diondokter/Tscrump-Weather-Station/App/WhatsApp Image 2017-02-02 at 12.11.14.jpeg

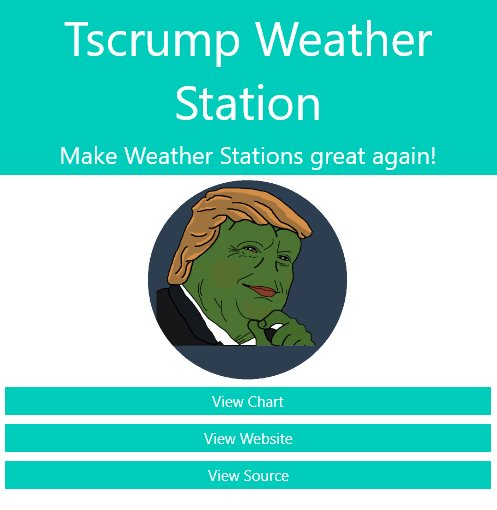
App/WhatsApp Image 2017-02-02 at 12.11.14.jpeg
