diondokter/Tscrump-Weather-Station/Arduino/tippingbucket/WhatsApp Image 2017-02-02 at 13.17.48.jpeg

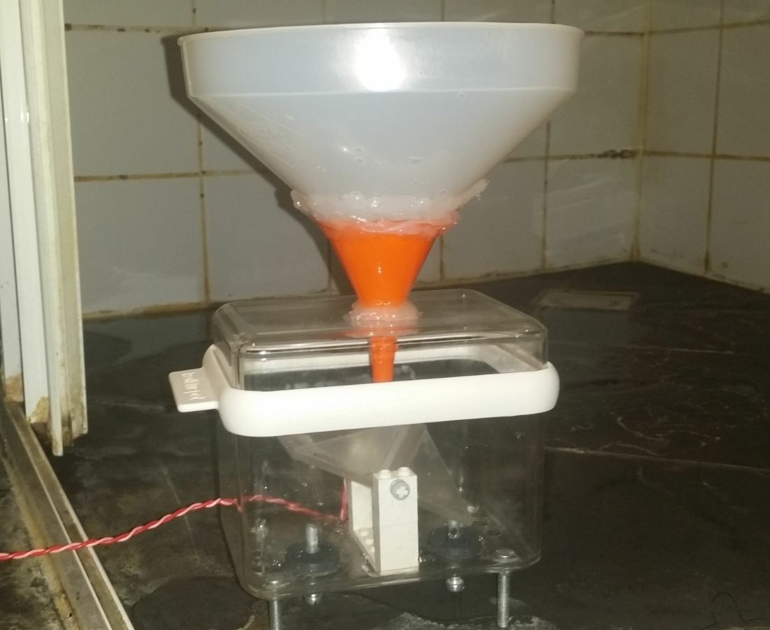
Arduino/tippingbucket/WhatsApp Image 2017-02-02 at 13.17.48.jpeg
