diondokter/Tscrump-Weather-Station/README.md

# Tscrump-Weather-Station
Project for making a weather station.
