diondokter/Tscrump-Weather-Station/Arduino/tippingbucket/tipping-bucket-rain-gauge.gif

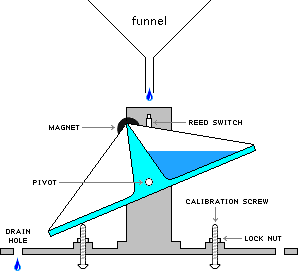
Arduino/tippingbucket/tipping-bucket-rain-gauge.gif
