diondokter/Tscrump-Weather-Station/Arduino/tippingbucket/tippingbucketdesign.png

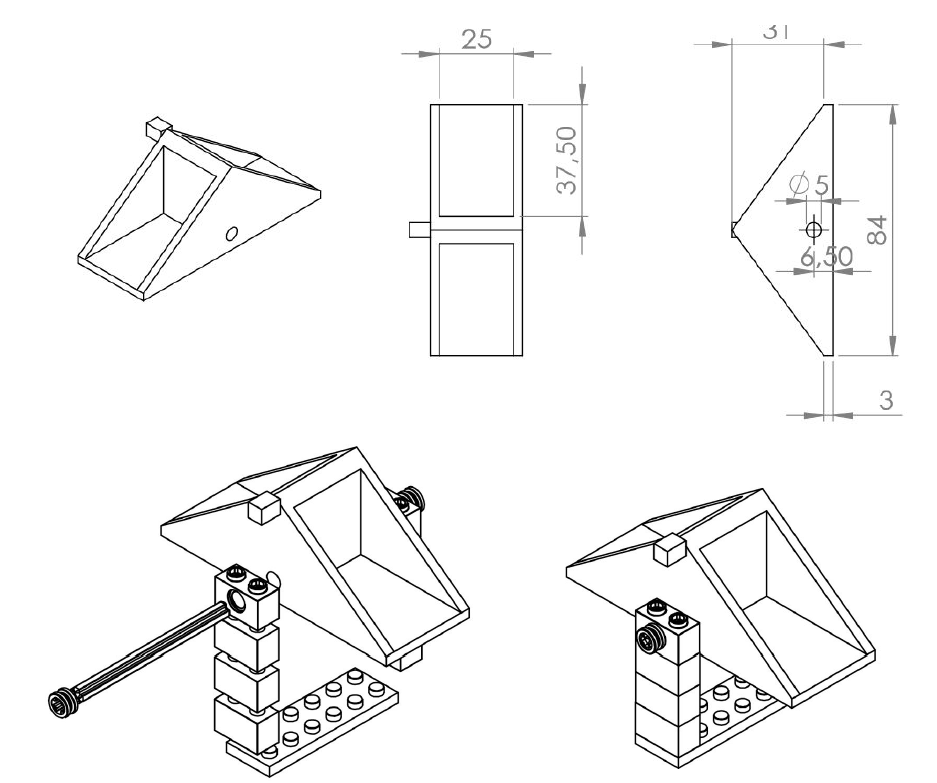
Arduino/tippingbucket/tippingbucketdesign.png
