diondokter/Tscrump-Weather-Station/Website/img/profile.png

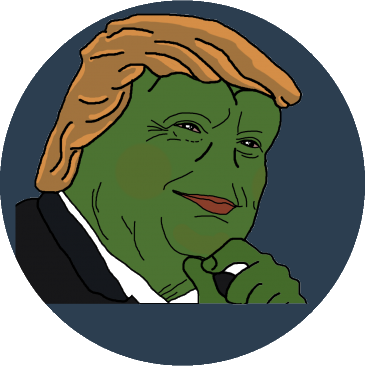
Website/img/profile.png
