diondokter/Tscrump-Weather-Station/Website/projectstructure.PNG

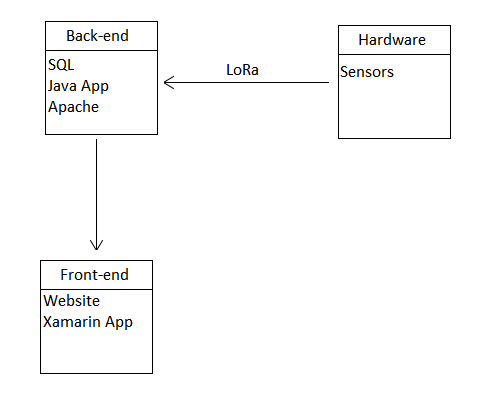
Website/projectstructure.PNG
