diondokter/Tscrump-Weather-Station/Website/Tscrump site picture.PNG

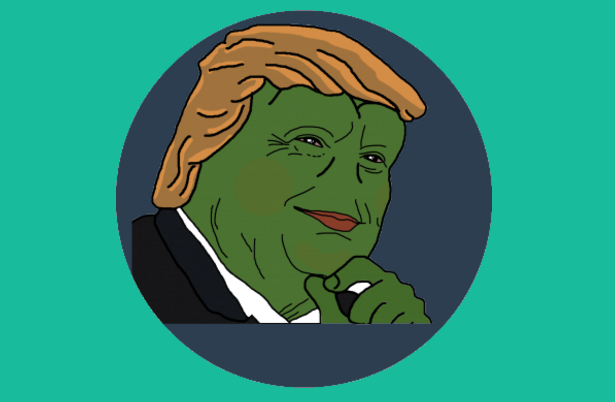
Website/Tscrump site picture.PNG
