diondokter/Tscrump-Weather-Station/ServerSide_App/TheThingNetworkGUI/src/sample/Main.java

package sample;

import javafx.application.Application;
import javafx.fxml.FXMLLoader;
import javafx.scene.Parent;
import javafx.scene.Scene;
import javafx.stage.Stage;

public class Main extends Application {

    @Override
    public void start(Stage primaryStage) throws Exception{
        Parent root = FXMLLoader.load(getClass().getResource("TtnCredentials.fxml"));
        primaryStage.setTitle("Hello World");
        primaryStage.setScene(new Scene(root,300,300));
        primaryStage.show();
    }


    public static void main(String[] args) {

        launch(args);
    }
}
