diondokter/Tscrump-Weather-Station/(commit log)

2016-11-19 added arduino code for the BMP180
2016-11-20 added deployment script
    Dit script zorgt ervoor dat de site automatisch update wanneer master word geupdate
2016-11-21 MySQL Connector now gets saved. (Change in GitIgnore)
2016-11-21 Changed de dbname into dummyweatherstation
2016-11-25 Made changes to the website so that it will work for mobile devices.
2016-11-25 Added the initial schematics
    [scrump.brd, scrump.sch]
2016-11-27 new dht11 library provided by DFRobot
    since the adafruit library didnt work well i found a new library that works well with the our sensor.
2016-11-28 Java application that connects to a Mqtt broker
    There are 3 classes:
    1- PahoDemo class
    2- PahoMqttCleint class: which is a class that uses Paho to connect to any broker
    3- Main class: this class was used to test the TTN java library.
    [Main.java]
2016-11-28 Added the initial schematics - Added BOM and library - Schematics in their own folder - Added gitignore - Added battery option to board
    [scrump.brd, scrump.sch]
2016-11-29 Changed the x-axis titless
2016-11-30 Fixed issues after review - Missing 3.3V line on Vddana - Added decoupling cap for second vddio - Removed pull-up on swdclk, which is usually included in the programmer itself. - Added 22 ohm resisto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
    [scrump.brd, scrump.sch]
2016-12-01 Added DHT11
    [scrump.brd, scrump.sch]
2016-12-12 Added gui and DBmanager with some fixes to the mqtt class
    [Main.java]
2016-12-12 full commit of code and a note.
    This code lacks a function that sends the amount of rain that has fallen (equal to the product of mmpertip and tipCounter) over the LoRa network, and then resets the tipCounter variable. This is dependent on the entire codebase.
    [tippingbucket.ino]
2016-12-19 Updated the Temperature Graph
    Fixed it so that the negative value's of the temperature will work aswell!
2017-01-07 Final version: - Fixed power delivery - Added sensors - Minor changes to schematic - Completed PCB - Used for production
    [scrump.brd, scrump.sch]
2017-01-15 Final BOM - Added passive components - Changed the power inductor(out of stock)
2017-01-17 the DB insert is more dynamic now and weatherDAO is a function in PahoMqttClient
2017-01-18 Nog een tekening voor de wiki
    staat momenteel op imgur, maar is beter als alles op github staat.
2017-01-19 reciving data from new arduino code
2017-01-20 Changed pressure tag from bar to hPa
